lbehrler/EANx-Analyzer-Arduino/Wikifiles/Back - EANx Analyzer Big Hat.png

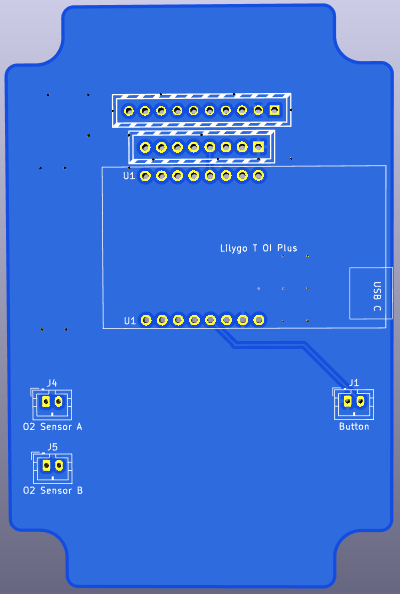
Wikifiles/Back - EANx Analyzer Big Hat.png
