lbehrler/EANx-Analyzer-Arduino/Wikifiles/Front - EANx Analyzer Big Hat.png

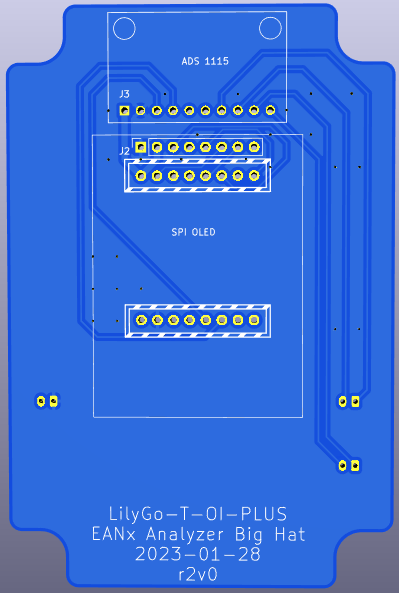
Wikifiles/Front - EANx Analyzer Big Hat.png
