lbehrler/EANx-Analyzer-Arduino/Wikifiles/Big Hat Step 1.png

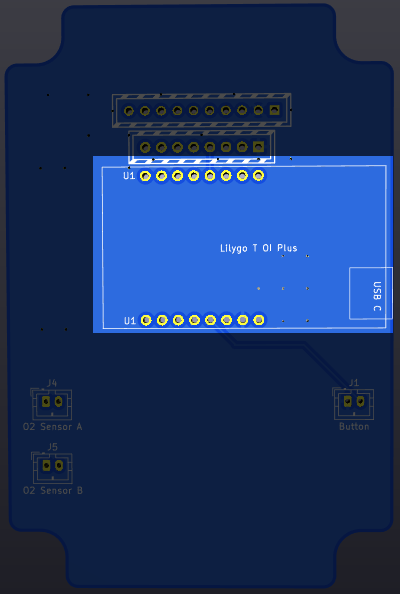
Wikifiles/Big Hat Step 1.png
