lbehrler/EANx-Analyzer-Arduino/Wikifiles/Big Hat Step 3.png

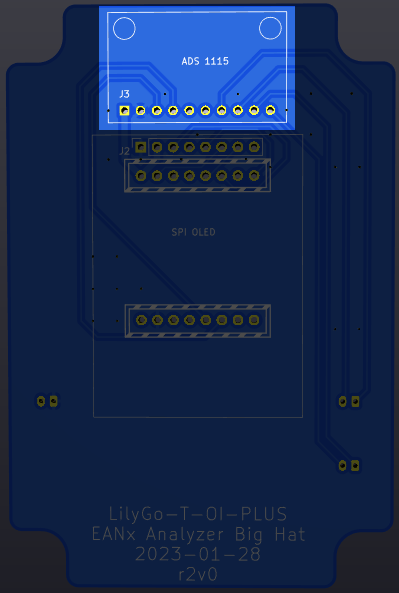
Wikifiles/Big Hat Step 3.png
