lbehrler/EANx-Analyzer-Arduino/Wikifiles/Big Hat Step 5.png

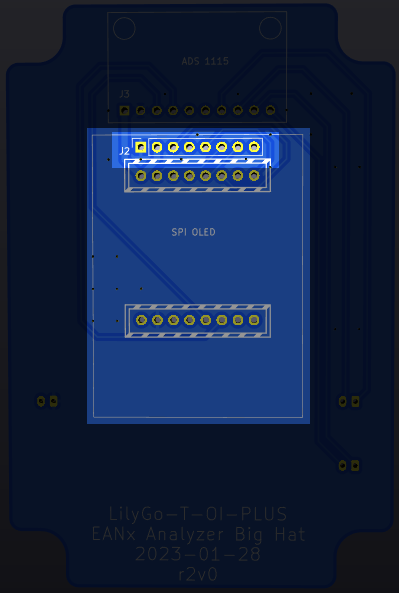
Wikifiles/Big Hat Step 5.png
