lbehrler/EANx-Analyzer-Arduino/EANx_Analyzer_OLED_TFT_eSPI/pin_config.h

/*
 *  Chip Specific settings to interface wiht OTA, battery status and LCD
 */ 

#if defined(ARDUINO_FEATHER_ESP32) // Feather Huzzah32
  #define TFT_CS         14
  #define TFT_RST        15
  #define TFT_DC         32

#elif defined(ESP8266)
  #define TFT_CS         4
  #define TFT_RST        16                                            
  #define TFT_DC         5

#elif defined(SEEED_XIAO_M0)  // Seeed XIAO
  #define SDA           4     
  #define SCL           5
  #define TFT_CS        7
  #define TFT_RST       -1     // Or set to -1 and connect to Arduino RESET pin
  #define TFT_DC        6
  #define TFT_MOSI      10    // Data out
  #define TFT_SCLK      8     // Clock out
  #define BUTTON_PIN    1
  #define VAL_MCU       "Seeed Xiao M0"

#elif defined(ARDUINO_XIAO_ESP32C3)  // Seeed XIAO ESP32 C3
  #define SDA           6     
  #define SCL           7
  #define TFT_CS        5
  #define TFT_DC        4
  #define TFT_MOSI      10    // Data out
  #define TFT_SCLK      8     // Clock out  
  #define TFT_RST       -1    // Or set to -1 and connect to Arduino RESET pin 
  #define BUTTON_PIN    3
  #define VAL_MCU       "Seeed Xiao ESP32 C3"
  #include "bat_stat.h"
  #define BAT_ADJ       0.85

#elif defined(ARDUINO_ESP32_PICO)
  #define TFT_SDA       21     
  #define TFT_SCL       22
  #define TFT_MOSI      23    // Data out
  #define TFT_SCLK      18    // Clock out  #define 
  #define TFT_RST       5     // Or set to -1 and connect to Arduino RESET pin                                            
  #define TFT_DC        10
  #define TFT_CS        9
  #define BUTTON_PIN    4
  #define VAL_MCU       "ESP32 Pico D4"
  #include "bat_stat.h"
  #define BAT_ADJ       1.0

#elif defined(ARDUINO_AVR_NANO)
  #define TFT_SDA       23     
  #define TFT_SCL       24
  #define TFT_MOSI      11    // Data out
  #define TFT_SCLK      13    // Clock out  #define 
  #define TFT_RST       -1    // Or set to -1 and connect to Arduino RESET pin                                            
  #define TFT_DC        9
  #define TFT_CS        10
  #define BUTTON_PIN    2
  #define VAL_MCU       "Arduino Nano"

#elif defined(ARDUINO_TINYS3)
  #define TFT_SDA       8    
  #define TFT_SCL       9
  #define TFT_MISO      37
  #define TFT_MOSI      35    // Data out
  #define TFT_SCLK      36    // Clock out  #define 
  #define TFT_RST       -1    // Or set to -1 and connect to Arduino RESET pin                                            
  #define TFT_DC        3
  #define TFT_CS        34
  #define BUTTON_PIN    4
  #define VAL_MCU       "UM Tiny S3 ESP32"
  #include "bat_stat.h"
  #define BAT_ADJ       1.0

#elif defined(ARDUINO_TTGO)  //Lilygo OI
  #define SDA           19    
  #define SCL           18
  // Traditional Pin Setup
  #define TFT_MOSI      6    // Data out
  #define TFT_SCLK      4    // Clock out  #define 
  #define TFT_DC        10
  #define TFT_CS        5  //Unused MISO pin


  /*// Hybrid Straight Line PCB Setup
  #define TFT_CS        4
  #define TFT_DC        5
  #define TFT_MOSI      6    // Data out
  #define TFT_SCLK      10     // Clock out  */
  
  #define TFT_RST       -1    // Or set to -1 and connect to Arduino RESET pin

  #define BUTTON_PIN    9
  #define VAL_MCU       "Lilygo T OI ESP32 C3"
  #include "bat_stat.h"
  #define BAT_ADJ       1.0

#else
  // For the breakout board, you can use any 2 or 3 pins.
  // These pins will also work for the 1.8" TFT shield.
  #define TFT_RST       -1    // Or set to -1 and connect to Arduino RESET pin                                            
  #define TFT_DC        4
  #define TFT_CS        10
  #define VAL_MCU       "Unknown"
#endif
