lbehrler/EANx-Analyzer-Arduino/EANx_Analyzer_SPI_OLED/EANx_Analyzer_SPI_OLED.ino

/*****************************************************************************

  EANx Analysis with output to an OLED color display

  Reads an analog input on pin, converts it to voltage, grabs a running average 
  of ADC values and and prints the result to the display and debug to Serial Monitor.

  Based on prior EANx scripts: 
  https://github.com/ppppaoppp/DIY-Nitrox-Analyzer-04_12_2019.git
  https://github.com/ejlabs/arduino-nitrox-analyzer.git

*****************************************************************************/

// Libraries
#include <RunningAverage.h>
#include <SPI.h>
#include <Adafruit_GFX.h>  // Core graphics library
#include <Fonts/FreeSans12pt7b.h>
#include <Fonts/FreeSans18pt7b.h>
#include <Fonts/FreeSans24pt7b.h>
#include <Adafruit_ST7789.h>  // Hardware-specific library for ST7789
#include <Adafruit_ADS1X15.h>
#include <splash.h>
#include "pin_config.h"
#include "display_cfg.h"

// Running Average definitions
#define RA_SIZE 20           //Define running average pool size
RunningAverage RA(RA_SIZE);  //Initialize Running Average

Adafruit_ADS1115 ads;  // Define ADC - 16-bit version

// Global Variabls
float prevaveSensorValue = 0;
float aveSensorValue = 0;
float prevvoltage = 0;
float voltage = 0;
float prevO2 = 0;
float currentO2 = 0;
float calFactor = 1;
int modfsw = 0;
int modmsw = 0;
int prevmodfsw = 0;
int prevmodmsw = 0;
float modppo = 1.4;
float multiplier = 0;



void setup() {
  Serial.begin(115200);

  if (OTACHK != 0) {
    ArduinoOTA.setHostname(OTADEVICE);
    setupOTA(OTADEVICE, mySSID, myPASSWORD);
  } 

  initst7789();

  tft.fillScreen(ST77XX_BLACK);
  testfillcircles(10, ST77XX_BLUE);
  testdrawcircles(10, ST77XX_WHITE);
  delay(500);

//  safetyrule();

  // setup display and calibrate unit

  o2calibration();
  printLayout();
}

// the loop routine runs over and over again forever:
void loop() {
  // Enable for OTA
  if (OTACHK != 0) { ArduinoOTA.handle(); }
  multiplier = initADC();

  // get running average value from ADC input Pin
  RA.clear();
  for (int x = 0; x <= RA_SIZE; x++) {
    int sensorValue = 0;
    sensorValue = ads.readADC_Differential_0_1();
    RA.addValue(sensorValue);
    delay(16);
    // Serial.println(sensorValue);    //mV serial print for debugging
  }

  // Record old and new ADC values
  prevaveSensorValue = aveSensorValue;
  prevO2 = currentO2;
  prevvoltage = voltage;
  prevmodfsw = modfsw;
  prevmodmsw = modmsw;
  aveSensorValue = RA.getAverage();

  currentO2 = (aveSensorValue * calFactor);  // Units: pct
  if (currentO2 > 99.9) currentO2 = 99.9;

  voltage = (aveSensorValue * multiplier);  // Units: mV

  modfsw = 33 * ((modppo / (currentO2 / 100)) - 1);
  modmsw = 10 * ((modppo / (currentO2 / 100)) - 1);

  // DEBUG print out the value you read:
  Serial.print("ADC Raw Diff = ");
  Serial.print(aveSensorValue);
  Serial.print("  ");
  Serial.print("Voltage = ");
  Serial.print(voltage);
  Serial.print(" mV");
  Serial.print("  ");
  Serial.print("O2 = ");
  Serial.print(currentO2);
  Serial.print("% ");
  Serial.print(modfsw);
  Serial.println(" FT");

  // Display values on OLED
  if (prevvoltage != voltage) {
    deleteVoltage();
    printVoltage();
  }

  if (prevO2 != currentO2) {
    deleteo2();
    printo2();
  }

  if (prevmodfsw != modfsw) {
    deletemod();
    printmod();
  }
}

void o2calibration() {
  //display "Calibrating"
  tft.fillScreen(ST77XX_BLACK);
  tft.setTextColor(ST77XX_WHITE);
  tft.setTextSize(1);
  tft.setFont(&FreeSans18pt7b);
  tft.setCursor(0, TFT_HEIGHT * .1);
  tft.println(F("++++++++++"));
  tft.println();
  tft.println(F("Calibrating"));
  tft.println(F("O2 Sensor"));
  tft.println();
  tft.println(F("++++++++++"));
  Serial.println("Calibration Screen Text");

  initADC();

  Serial.println("Post ADS check statement");
  // get running average value from ADC input Pin
  RA.clear();
  for (int x = 0; x <= (RA_SIZE * 5); x++) {
    int sensorValue = 0;
    sensorValue = ads.readADC_Differential_0_1();
    RA.addValue(sensorValue);
    delay(16);
    Serial.print("calibrating ");
    Serial.println(sensorValue);  //mV serial print for debugging
  }
  tft.fillScreen(ST77XX_BLACK);
  calFactor = (1 / RA.getAverage() * 20.900);  // Auto Calibrate to 20.9%
}

void printmod() {
  tft.setCursor(TFT_WIDTH * .5, TFT_HEIGHT * .8);
  tft.setFont(&FreeSans12pt7b);
  tft.setTextSize(1);
  tft.setTextColor(ST77XX_YELLOW);
  tft.print(modfsw);
  tft.print(" FT");
  tft.setCursor(TFT_WIDTH * .55, TFT_HEIGHT * .9);
  tft.print(modmsw);
  tft.println(" m");
}

void deletemod() {
  tft.setCursor(TFT_WIDTH * .5, TFT_HEIGHT * .8);
  tft.setFont(&FreeSans12pt7b);
  tft.setTextSize(1);
  tft.setTextColor(ST77XX_BLACK);
  tft.print(prevmodfsw);
  tft.print(" FT");
  tft.setCursor(TFT_WIDTH * .55, TFT_HEIGHT * .9);
  tft.print(prevmodmsw);
  tft.println(" m");
}

void printVoltage() {
  tft.setCursor(TFT_WIDTH * .20, TFT_HEIGHT * .8);
  tft.setTextSize(1);
  tft.setFont(&FreeSans12pt7b);
  tft.setTextColor(ST77XX_RED);
  tft.println(voltage, 1);
}

void deleteVoltage() {
  tft.setCursor(TFT_WIDTH * .20, TFT_HEIGHT * .8);
  tft.setTextSize(1);
  tft.setFont(&FreeSans12pt7b);
  tft.setTextColor(ST77XX_BLACK);
  tft.println(prevvoltage, 1);
}

void printo2() {
  tft.setCursor(TFT_WIDTH * .15, TFT_HEIGHT * .5);
  tft.setTextSize(2);
  tft.setFont(&FreeSans24pt7b);
  if (currentO2 > 20 and currentO2 < 22) { tft.setTextColor(ST77XX_CYAN, ST77XX_BLACK); }
  if (currentO2 < 20) { tft.setTextColor(ST77XX_RED, ST77XX_BLACK); }
  if (currentO2 > 22) { tft.setTextColor(ST77XX_GREEN, ST77XX_BLACK); }
  tft.println(currentO2, 1);
}

void deleteo2() {
  tft.setCursor(TFT_WIDTH * .15, TFT_HEIGHT * .5);
  tft.setTextSize(2);
  tft.setFont(&FreeSans24pt7b);
  tft.setTextColor(ST77XX_BLACK);
  tft.println(prevO2, 1);
}

void printLayout() {
  tft.setCursor(TFT_WIDTH * .15, TFT_HEIGHT * .15);
  tft.setTextSize(1);
  tft.setFont(&FreeSans24pt7b);
  tft.setTextColor(ST77XX_GREEN);
  tft.println("O2 %");
  tft.setFont(&FreeSans18pt7b);
  tft.setTextColor(ST77XX_BLUE);
  tft.setCursor(TFT_WIDTH * .15, TFT_HEIGHT * .7);
  tft.print("mV");
  tft.setTextColor(ST77XX_ORANGE);
  tft.setCursor(TFT_WIDTH * .5, TFT_HEIGHT * .7);
  tft.println("MOD");
}




float initADC() {
  // init ADC and Set gain

  // The ADC input range (or gain) can be changed via the following
  //                                                                ADS1015  ADS1115
  //                                                                -------  -------
  // ads.setGain(GAIN_TWOTHIRDS);  // 2/3x gain +/- 6.144V  1 bit = 3mV      0.1875mV (default)
  // ads.setGain(GAIN_ONE);        // 1x gain   +/- 4.096V  1 bit = 2mV      0.125mV
  ads.setGain(GAIN_TWO);  // 2x gain   +/- 2.048V  1 bit = 1mV      0.0625mV
  // ads.setGain(GAIN_FOUR);       // 4x gain   +/- 1.024V  1 bit = 0.5mV    0.03125mV
  // ads.setGain(GAIN_EIGHT);      // 8x gain   +/- 0.512V  1 bit = 0.25mV   0.015625mV
  // ads.setGain(GAIN_SIXTEEN);    // 16x gain  +/- 0.256V  1 bit = 0.125mV  0.0078125mV

  /* Be sure to update this value based on the IC and the gain settings! */
  //float   multiplier = 3.0F;    /* ADS1015 @ +/- 6.144V gain (12-bit results) */
  float multiplier = 0.0625; /* ADS1115  @ +/- 6.144V gain (16-bit results) */

  // Check that the ADC is operational
  if (!ads.begin()) {
    Serial.println("Failed to initialize ADS.");
    tft.fillScreen(ST77XX_YELLOW);
    tft.setCursor(0, 30);
    tft.setTextSize(1);
    tft.setTextColor(ST77XX_RED);
    tft.println(F("Error"));
    tft.println(F("No ADC"));
    while (1)
      ;
  }
  return (multiplier);
}

void testfillcircles(uint8_t radius, uint16_t color) {
  for (int16_t x = radius; x < tft.width(); x += radius * 2) {
    for (int16_t y = radius; y < tft.height(); y += radius * 2) {
      tft.fillCircle(x, y, radius, color);
    }
  }
}

void testdrawcircles(uint8_t radius, uint16_t color) {
  for (int16_t x = 0; x < tft.width() + radius; x += radius * 2) {
    for (int16_t y = 0; y < tft.height() + radius; y += radius * 2) {
      tft.drawCircle(x, y, radius, color);
    }
  }
}

/* void safetyrule() {
  tft.fillScreen(ST77XX_BLACK);
  tft.setTextColor(ST77XX_YELLOW);
  tft.setTextSize(1 * ResFact);
  randomSeed(millis());
  int randNumber = random(5);
  Serial.println(randNumber);
  if (randNumber == 0) {
    tft.drawString("Seek proper", TFT_WIDTH * .0, TFT_HEIGHT * .10, 2);
    tft.drawString("training", TFT_WIDTH * .0, TFT_HEIGHT * .20, 2);
  } else if (randNumber == 1) {
    tft.drawString("Maintain a", TFT_WIDTH * .0, TFT_HEIGHT * .10, 2);
    tft.drawString("continious", TFT_WIDTH * .0, TFT_HEIGHT * .20, 2);
    tft.drawString("guideline to", TFT_WIDTH * .0, TFT_HEIGHT * .30, 2);
    tft.drawString("the surface", TFT_WIDTH * .0, TFT_HEIGHT * .40, 2);
  } else if (randNumber == 2) {
    tft.drawString("Stay within", TFT_WIDTH * .0, TFT_HEIGHT * .10, 2);
    tft.drawString("your depth", TFT_WIDTH * .0, TFT_HEIGHT * .20, 2);
    tft.drawString("limitations", TFT_WIDTH * .0, TFT_HEIGHT * .30, 2);
  } else if (randNumber == 3) {
    tft.drawString("Proper gas", TFT_WIDTH * .0, TFT_HEIGHT * .10, 2);
    tft.drawString("management", TFT_WIDTH * .0, TFT_HEIGHT * .20, 2);
  } else {
    tft.drawString("Use appropriate", TFT_WIDTH * .0, TFT_HEIGHT * .10, 2);
    tft.drawString("properly maintaned", TFT_WIDTH * .0, TFT_HEIGHT * .20, 2);
    tft.drawString("equipment", TFT_WIDTH * .0, TFT_HEIGHT * .30, 2);
  }
  delay(3000);
  tft.fillScreen(ST77XX_BLACK);
} */
