lbehrler/EANx-Analyzer-Arduino/EANx_Analyzer_SPI_OLED/display_cfg.h

// STXXXX definitions
#define TFT_WIDTH  240   // OLED display width, in pixels
#define TFT_HEIGHT 240   // OLED display height, in pixels
#define ResFact        2    // 1 = 128x128   2 = 240x240

//Adafruit_ST7789 tft = Adafruit_ST7789(TFT_CS, TFT_DC, TFT_MOSI, TFT_SCLK, TFT_RST);  //Define OLED display
Adafruit_ST7789 tft = Adafruit_ST7789(TFT_DC, TFT_MOSI, TFT_SCLK, TFT_RST);  //Define OLED display

void initst7789() {
  tft.init(TFT_WIDTH, TFT_HEIGHT);  // Init ST7789 240x240
  tft.setRotation(0);                     // Adjust SS7789 Orientation

  Serial.println("Display Initialized");  
  tft.setCursor(0, TFT_HEIGHT*.2);
  tft.fillScreen(ST77XX_GREEN);
  tft.setTextSize(1);
  tft.setFont(&FreeSans18pt7b);
  tft.setTextColor(ST77XX_BLACK);
  Serial.println("init display test done");
  tft.println("display");
  tft.println("init");
  tft.println("complete");
  delay(500);
  tft.fillScreen(ST77XX_BLACK);
}
