lbehrler/EANx-Analyzer-Arduino/(commit log)

2022-11-28 Muti chipset support added
    Support for ESP32 PICO and Seed added.
2022-12-01 Code revisions for sensor
2022-12-01 Changes to Calibration Factor
2022-12-01 Adjust gain values for ADC
2022-12-01 Initial Schematics
2022-12-02 Added support for ST1306 I2C
2022-12-06 moved board configs to header file
2022-12-12 Remove default OTA for non Wifi devices
2022-12-13 TFT eSPI Driver Compatibility
2022-12-14 Corrections to ST7735 handling
    [EANx_Analyzer_OLED_TFT_eSPI.ino, EANx_Analyzer_SPI_OLED.ino, pin_config.h]
2022-12-15 Added ESP32 C3
2022-12-19 Fixed max O2 formula
    [EANx_Analyzer_OLED_TFT_eSPI.ino]
2022-12-19 redefined pin layout
2022-12-29 Added Battery Monitor
2022-12-30 Prototype photos
2023-01-04 Added PCB Pics
2023-02-02 added prototype picture
2023-03-06 Revert "header cleanup"
    This reverts commit dd3e7d9dc00419f09c95d0919b833caad93a9058.
    [OTA.h, display_cfg.h, pin_config.h]
2023-03-07 PCB Solder Guide
